brandonhanner/SeniorDesign/Aeroneers/Sketches/readme.md

**Aero_Main_button_test**

Testing the optoisolated inputs on the PCB of the final main board.
	
**Aero_Node_AeroCAN_Firmware**

Node firmware written using the AeroCAN library

**Aero_Node_Firmware**

Node firmware written before the creation of the library.

**Aero_Node_Tests**

Testing the functionality of the library for a node.

**Aero_Node_button_test**

Testing the optoisolated inputs on the PCB of the final node board.

**CAN_Collin_test**

Testing the CAN functionality of the Teensy.

**Filter_timer_test**

Testing the filter library.

**ForzaUDP2CAN**

Attempted branch implementing the AeroCAN library on other hardware.

**ForzaUDP2CANnoAeroCAN**

Sketch used to parse Forza data and control the attached nodes.

**MPU9250-SPI-TEENSY-TEST**

Testing the MPU9250 attached to the teensy.

**Teensy_3_2_Servo_test**

Testing the servo library on the teensy.

**Teensy_Timing_Test**

Testing the timing abilities of the Teensy reading the MPU over SPI.

**main**

Sketch for the main layer that will run on the main board.

**main_button_test**

Testing the inputs on the teensy 3.6

**node_button_test**

Testing the inputs on the teensy 3.2

**teensy3.2blink**

hello world on the teensy

**MPU9250.ino**
