brandonhanner/SeniorDesign/Aeroneers/CAD Files/3D Prints/outline.dxf

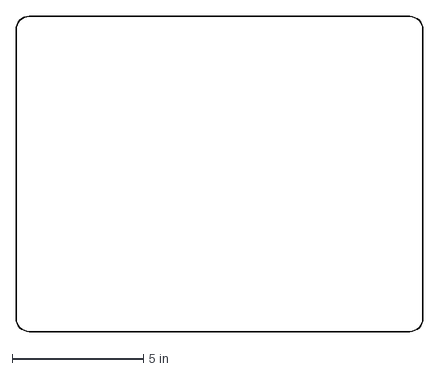
[picture p2: CAD file, 2019-05-07]
Aeroneers/CAD Files/3D Prints/outline.dxf
15.5 x 12.0 in
