brandonhanner/SeniorDesign/Aeroneers/CAD Files/3D Prints/Front Wing Other.stl

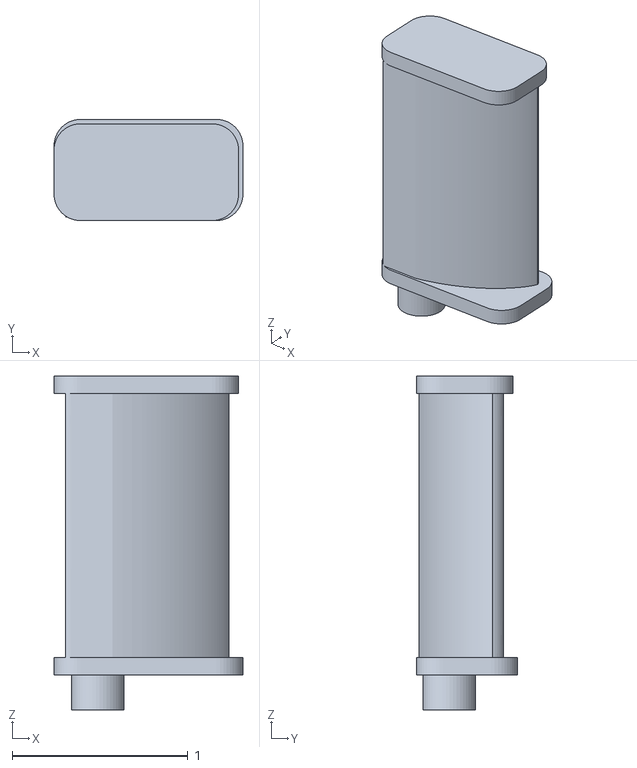
[picture p3: CAD file, 2019-05-07]
Aeroneers/CAD Files/3D Prints/Front Wing Other.stl
1.08 x 0.575 x 1.90
