brandonhanner/SeniorDesign/Aeroneers/CAD Files/3D Prints/Rear Wing.stl

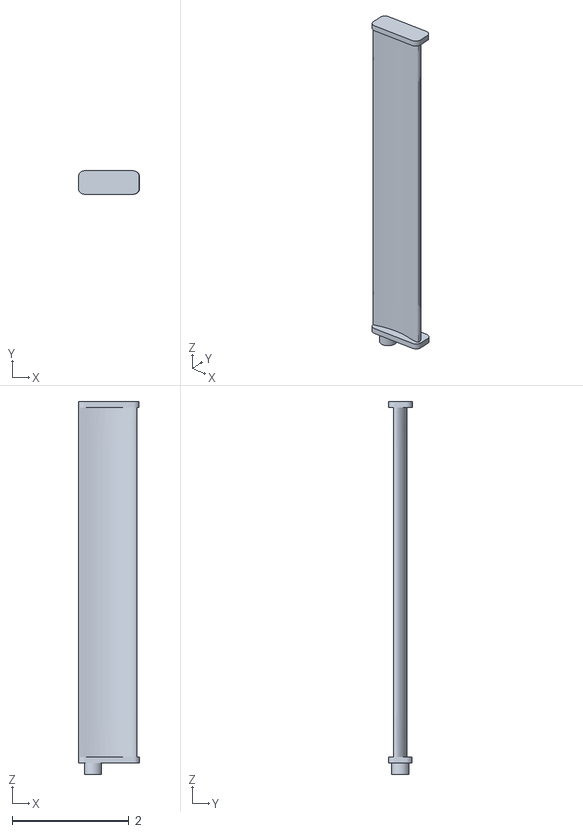
[picture p4: CAD file, 2019-05-07]
Aeroneers/CAD Files/3D Prints/Rear Wing.stl
1.05 x 0.404 x 6.40
