brandonhanner/SeniorDesign/Aeroneers/CAD Files/3D Prints/Node Holder.stl

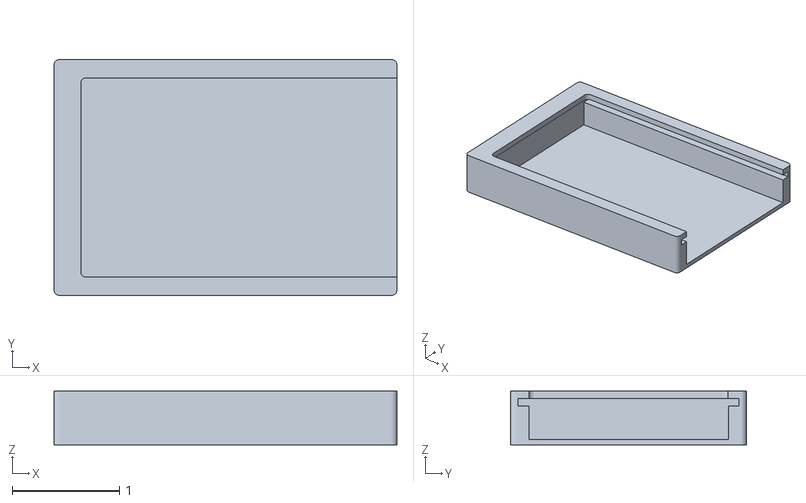
[picture p5: CAD file, 2019-05-07]
Aeroneers/CAD Files/3D Prints/Node Holder.stl
3.20 x 2.20 x 0.5
