brandonhanner/SeniorDesign/Aeroneers/CAD Files/3D Prints/servo holder.stl

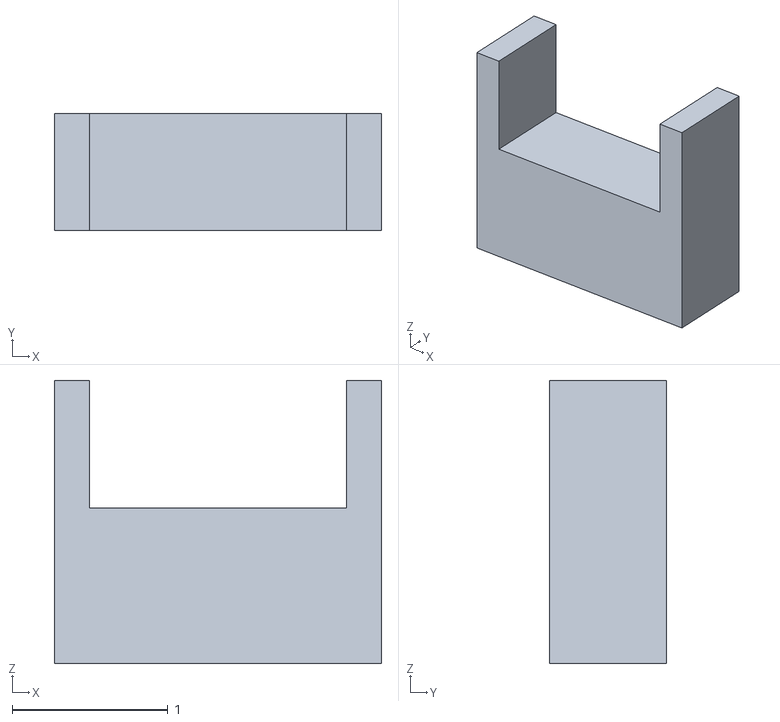
[picture p6: CAD file, 2019-05-07]
Aeroneers/CAD Files/3D Prints/servo holder.stl
2.10 x 0.75 x 1.82
