brandonhanner/SeniorDesign/Aeroneers/CAD Files/3D Prints/car.dxf

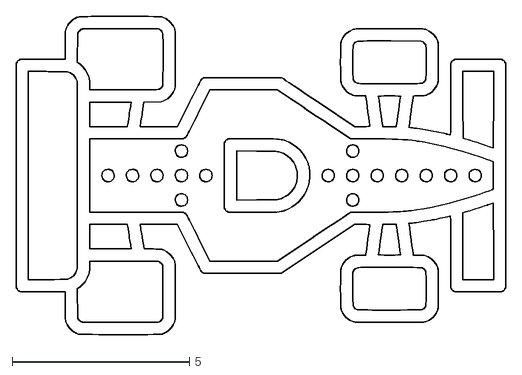
[picture p7: CAD file, 2019-05-07]
Aeroneers/CAD Files/3D Prints/car.dxf
13.8 x 8.98
