brandonhanner/SeniorDesign/(list of files, cad)

Other CAD files:
Aeroneers/CAD Files/3D Prints/Front Wing.stl
