brandonhanner/SeniorDesign/Aeroneers/CAD Files/PCBs/projects/FSAE NODE BOARD/node.brd

## EAGLE design Aeroneers/CAD Files/PCBs/projects/FSAE NODE BOARD/node.brd (2019-05-07)

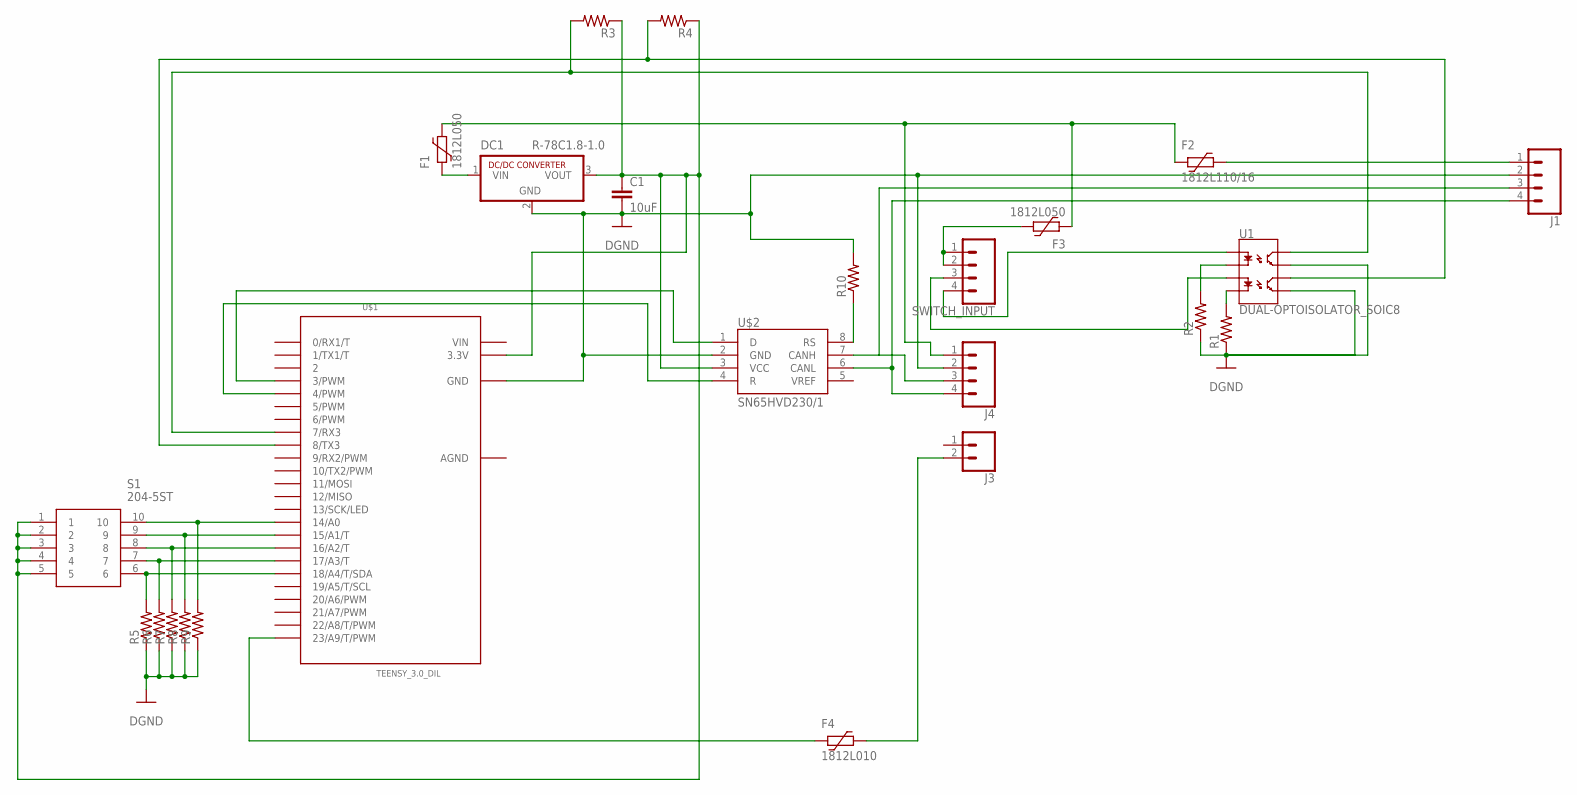
[picture p8: schematic node.sch]

Parts:
C1: 10uF; 1206
DC1: R-78C1.8-1.0; SIP3
F1, F3: 1812L050; 1812L
F2: 1812L110/16; 1812L
F4: 1812L010; 1812L
J1, J4: CONN_04POLAR; MOLEX-1X4
J3: CONN_02POLAR; MOLEX-1X2
R1, R2, R3, R4, R5, R6, R7, R8, R9, R10: R-US_R1206; R1206
S1: 204-5ST; SOP254P1152X760-10N
SWITCH_INPUT: CONN_04POLAR; MOLEX-1X4
U1: DUAL-OPTOISOLATOR_SOIC8; SO08
U$1: TEENSY_3.0_DIL; TEENSY_3.0-3.2&LC_DIL
U$2: SN65HVD230/1; SO8

Connections:
AGND: U$1.AGND
GND: C1.2, DC1.2 (GND), J1.2, J4.2, R1.1, R2.1, R5.1, R6.1, R7.1, R8.1, R9.1, R10.2, U1.5 (EM2), U1.7 (EM1), U$1.GND, U$2.2 (GND)
unnamed: U$1.3 (3/PWM), U$2.1 (D)
unnamed: U$1.4 (4/PWM), U$2.4 (R)
unnamed: C1.1, DC1.3 (VOUT), R3.1, R4.1, S1.1, S1.2, S1.3, S1.4, S1.5, U$1.3.3V, U$2.3 (VCC)
unnamed: SWITCH_INPUT.3, U1.3 (A2)
unnamed: SWITCH_INPUT.4, U1.1 (A1)
unnamed: F4.1, J3.2
unnamed: J1.3, J4.3, U$2.7 (CANH)
unnamed: J1.4, J4.4, U$2.6 (CANL)
unnamed: R9.2, S1.10, U$1.14/A0
unnamed: R1.2, U1.4 (C2)
unnamed: R2.2, U1.2 (C1)
unnamed: R3.2, U1.8 (CL1), U$1.7 (7/RX3)
unnamed: R4.2, U1.6 (CL2), U$1.8 (8/TX3)
unnamed: F1.1, F2.2, F3.2, J4.1
unnamed: F2.1, J1.1
unnamed: F3.1, SWITCH_INPUT.1, SWITCH_INPUT.2
unnamed: R8.2, S1.9, U$1.15/A1 (15/A1/T)
unnamed: R7.2, S1.8, U$1.16/A2 (16/A2/T)
unnamed: R6.2, S1.7, U$1.17/A3 (17/A3/T)
unnamed: R5.2, S1.6, U$1.18/A4 (18/A4/T/SDA)
unnamed: F4.2, U$1.23/A9 (23/A9/T/PWM)
unnamed: DC1.1 (VIN), F1.2
unnamed: R10.1, U$2.8 (RS)
VIN: U$1.VIN

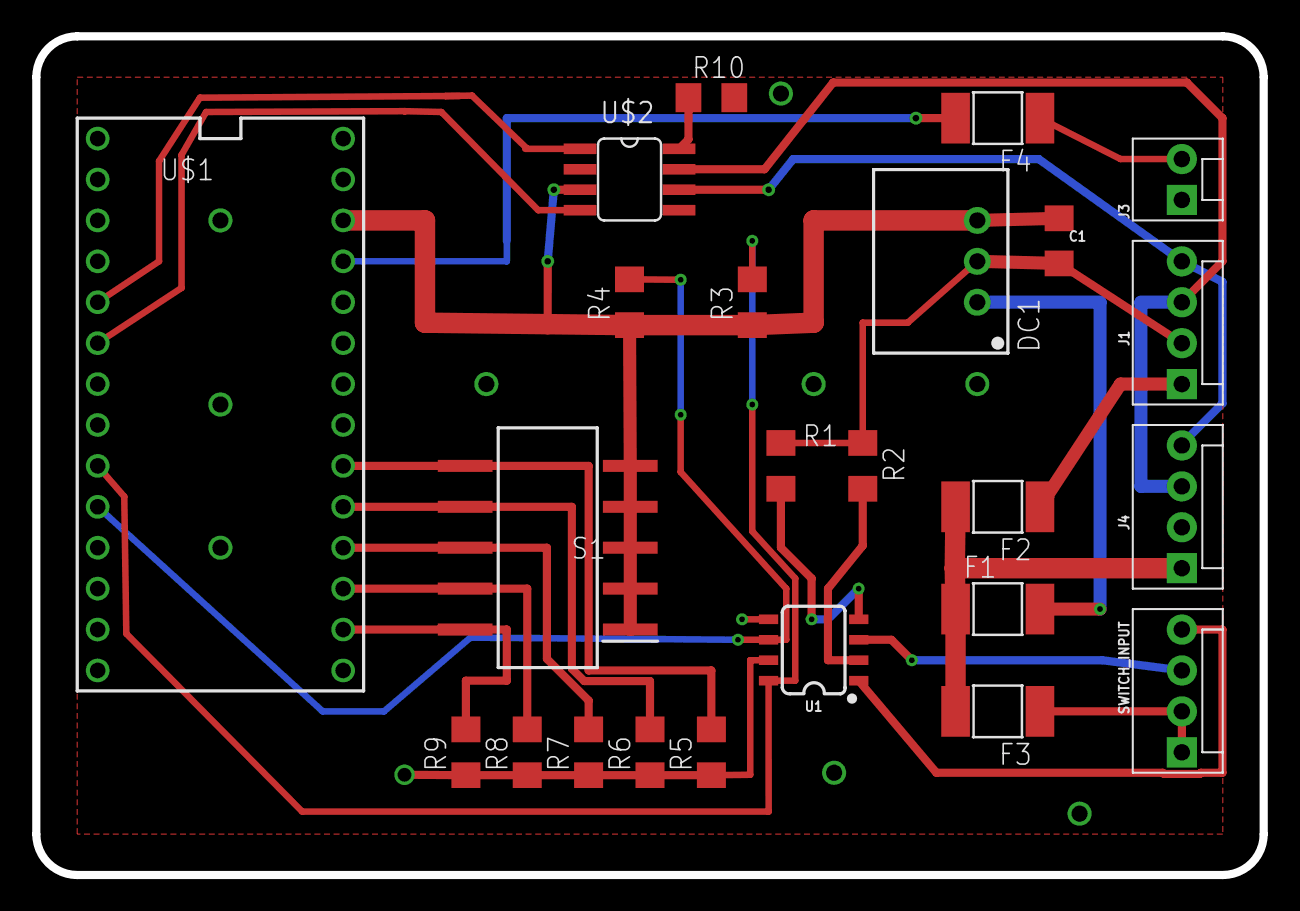
[picture p9: board node.brd from above]

Board: 2 copper layers, 76.2 x 52.1 mm, 24 parts (0 on the bottom side), 24 nets.
