brandonhanner/SeniorDesign/Aeroneers/CAD Files/PCBs/projects/FSAE CONTROLLER/FSAE_CONTROLLER.brd

## EAGLE design Aeroneers/CAD Files/PCBs/projects/FSAE CONTROLLER/FSAE_CONTROLLER.brd (2019-05-07)

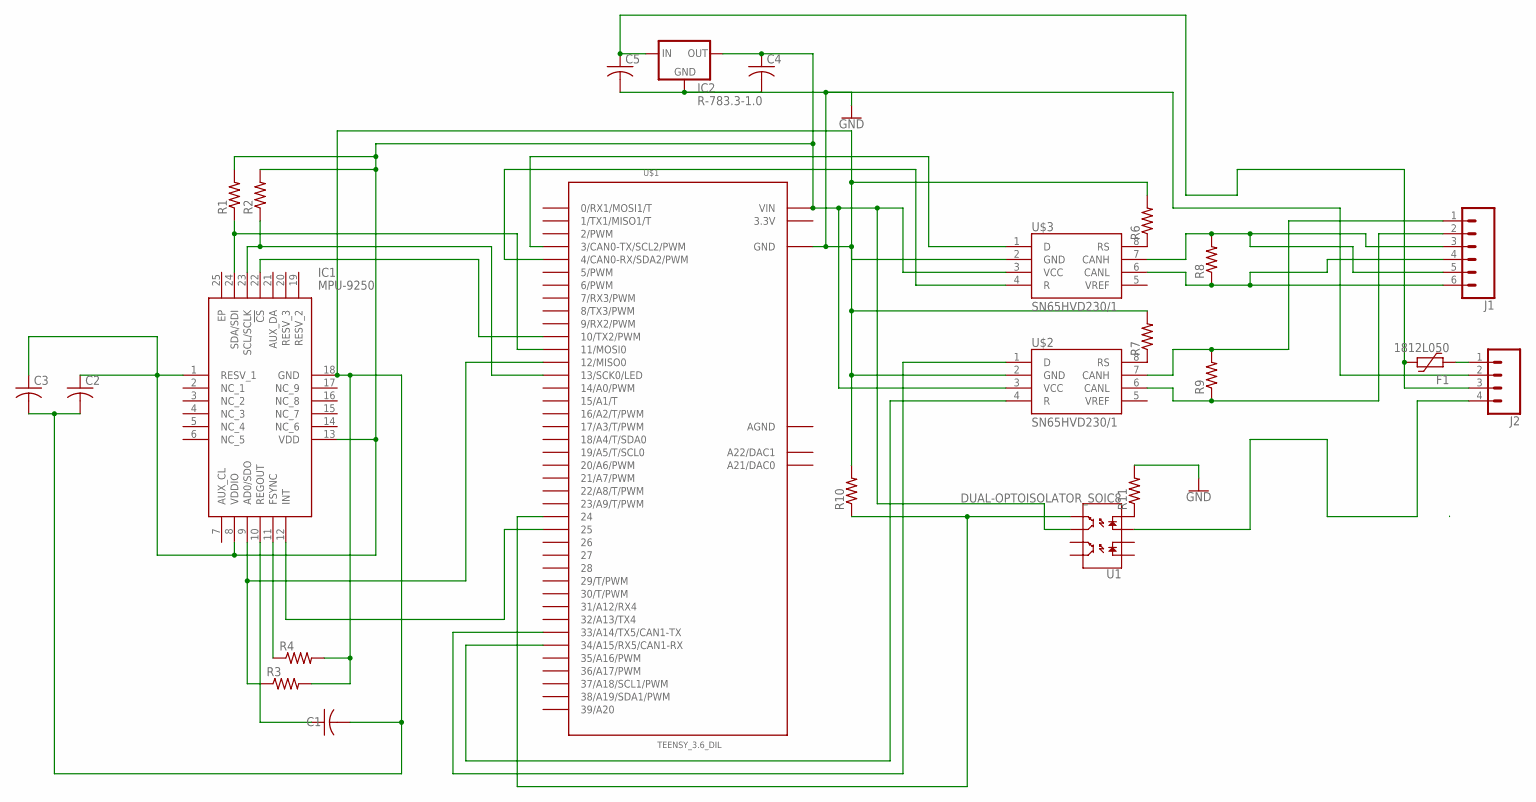
[picture p10: schematic FSAE_CONTROLLER.sch]

Parts:
C1, C2, C3, C4, C5: C-USC1206; C1206
F1: 1812L050; 1812L
IC1: MPU-9250; QFN40P300X300X105-25N
IC2: R-783.3-1.0; SIP3
J1: CONN_063.5MM-6; SCREWTERMINAL-3.5MM-6
J2: CONN_04SCREW; SCREWTERMINAL-3.5MM-4
R1, R2, R3, R4, R6, R7, R8, R9, R10, R11: R-US_R1206; R1206
U1: DUAL-OPTOISOLATOR_SOIC8; SO08
U$1: TEENSY_3.6_DIL
U$2, U$3: SN65HVD230/1; SO8

Connections:
3.3V: U$1.3.3V, U$1.3.3V3 (3.3V)
AGND: U$1.AGND
GND: C1.2, C2.2, C3.2, C4.2, C5.2, IC1.18 (GND), IC2.2 (GND), J2.2, R3.2, R4.2, R6.2, R7.2, R10.2, R11.2, U$1.GND, U$1.GND1 (GND), U$2.2 (GND), U$3.2 (GND)
unnamed: C5.1, F1.1, IC2.1 (IN), J2.3
unnamed: IC1.11 (FSYNC), R4.1
unnamed: C1.1, IC1.10 (REGOUT)
unnamed: IC1.23 (SCL/SCLK), R2.1, U$1.13 (13/SCK0/LED)
unnamed: IC1.24 (SDA/SDI), R1.1, U$1.11 (11/MOSI0)
unnamed: IC1.9 (AD0/SDO), R3.1, U$1.12 (12/MISO0)
unnamed: IC1.12 (INT), U$1.25
unnamed: IC1.22 (!CS), U$1.10 (10/TX2/PWM)
unnamed: R6.1, U$3.8 (RS)
unnamed: R7.1, U$2.8 (RS)
unnamed: U$1.3 (3/CAN0-TX/SCL2/PWM), U$3.1 (D)
unnamed: U$1.4 (4/CAN0-RX/SDA2/PWM), U$3.4 (R)
unnamed: J1.1, R9.2, U$2.7 (CANH)
unnamed: J1.3, J1.5, R8.2, U$3.7 (CANH)
unnamed: J1.4, J1.6, R8.1, U$3.6 (CANL)
unnamed: J1.2, R9.1, U$2.6 (CANL)
unnamed: U$1.33/A14 (33/A14/TX5/CAN1-TX), U$2.1 (D)
unnamed: U$1.34/A15 (34/A15/RX5/CAN1-RX), U$2.4 (R)
unnamed: R10.1, U1.5 (EM2), U$1.24
unnamed: R11.1, U1.4 (C2)
unnamed: F1.2, J2.1
unnamed: J2.4, U1.3 (A2)
unnamed: C2.1, C3.1, C4.1, IC1.1 (RESV_1), IC1.8 (VDDIO), IC1.13 (VDD), IC2.3 (OUT), R1.2, R2.2, U1.6 (CL2), U$1.VIN, U$2.3 (VCC), U$3.3 (VCC)

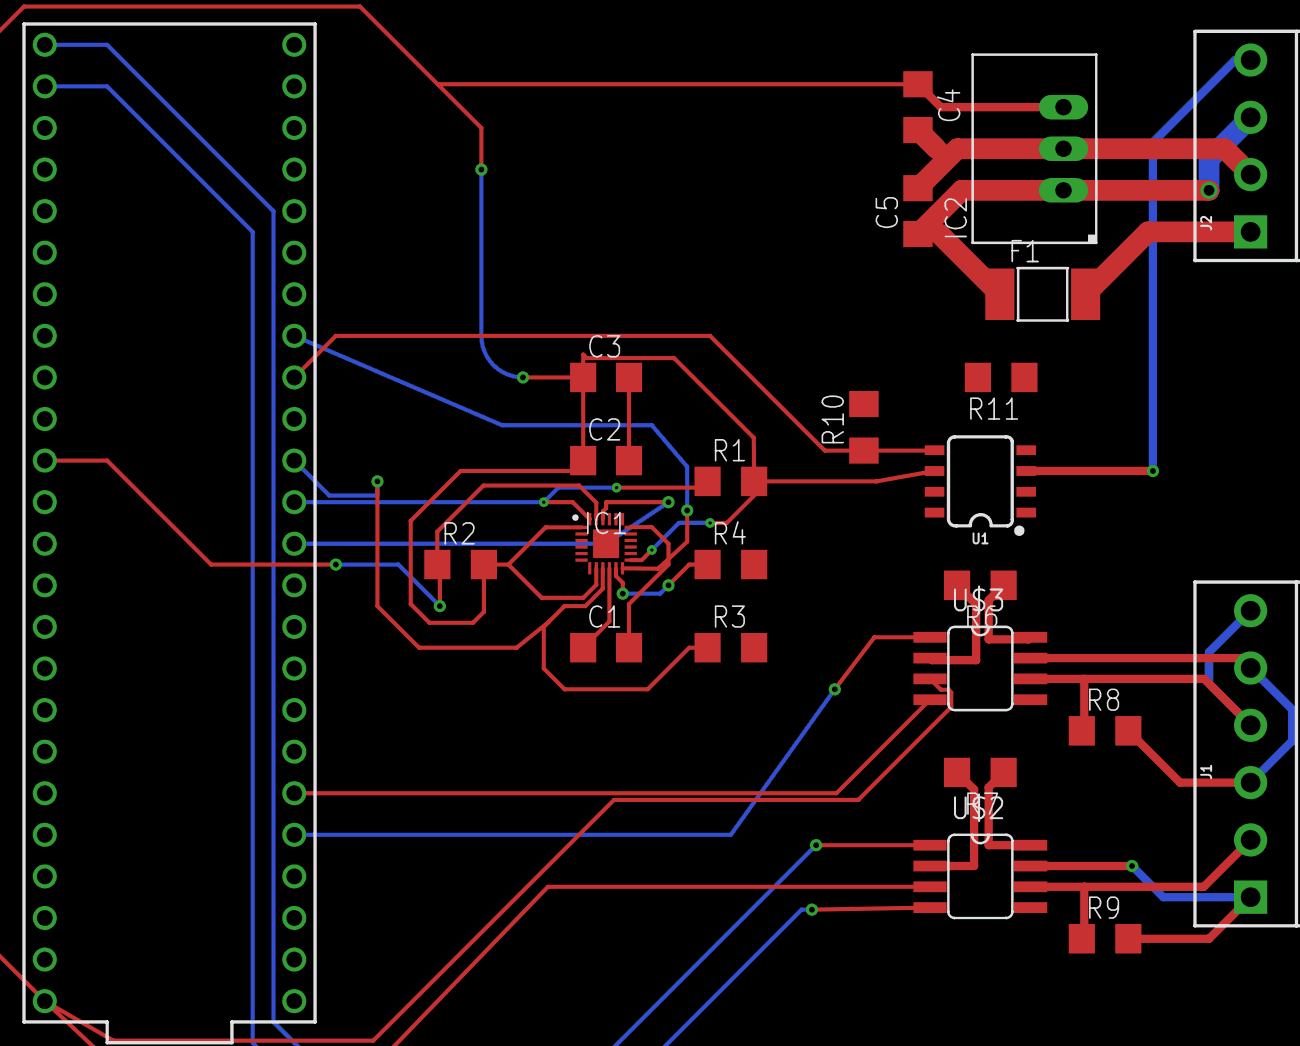
[picture p11: board FSAE_CONTROLLER.brd from above]

Board: 2 copper layers, 24 parts (0 on the bottom side), 25 nets.
