brandonhanner/SeniorDesign/(commit log)

2018-11-12 First Commit
    First Commit, with the driver for the MPU-9250 operational. Fleshing out the acquisition class, but only have the IMU class fully done, still working on filter and need to write the interface still.
2018-11-26 Testing some reatime stuff, no real updates here.. timertest was renamed timertest2 so I could restructure timertest to accomplish a different goal.
2018-12-03 Attempt at making faster reads from IMU
    added method on IMU class that doesnt pull temp or gyro readings in hopes that the read time drops..
2018-12-03 Updated timertest.cpp
    Updated to allow for mod of loop times and to add initial calibration of the sensor
2018-12-03 Messing with timertest
2018-12-03 updating timertest
    trying to figure out why loop can be less than 8ms in some cases..
2018-12-03 Cleaned up timertest
2019-02-26 Added millis timers to make the timeout function actually work.
2019-03-18 Functioning filter that's timer based
2019-03-18 Filter and timer libraries
2019-03-18 working timer based filtering program
2019-03-21 Lots of updates
    Fixed AeroCAN library issues such that the AeroCAN firmware now does 90% of what its supposed to.. still a function left to implement to return config and status but it works otherwise.
    Updated Aero_Node_Tests file to send all message types to the node and it is correctly parsing those messages at this time.
    Added the Aero_Node_AeroCAN firmware, system is now in object oriented style.
    [Aero_Node_AeroCAN_Firmware.ino, Aero_Node_Tests.ino]
2019-03-22 Added CAD Files for completed (minus connector) node board and schematic-complete main board
    [FSAE_CONTROLLER.brd, FSAE_CONTROLLER.sch, node.brd, node.sch]
2019-05-07 End of semester commit
    [FSAE_CONTROLLER_DEUTSCH.brd, FSAE_CONTROLLER_DEUTSCH.sch, node.sch]
