brandonhanner/SeniorDesign/(notices)

Notices in the files:
parts and their libraries:
r-78xx_10: (c) 2015 Samuel Lourenço
SparkFun-DiscreteSemi: Licensing: Creative Commons ShareAlike 4.0 International - https://creativecommons.org/licenses/by-sa/4.0
